jemmott/rotary-plasma/headstock/out/adapter_plate.dxf

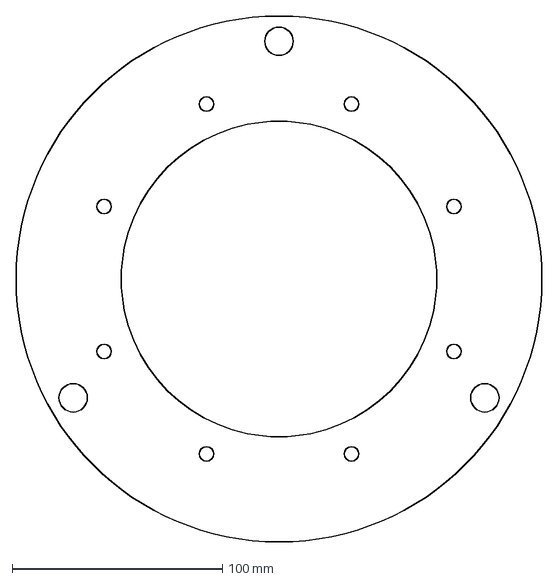
[picture p1: CAD file, 2026-11-13]
headstock/out/adapter_plate.dxf
250.0 x 250.0 mm
