jemmott/rotary-plasma/headstock/out/spacer_ring.dxf

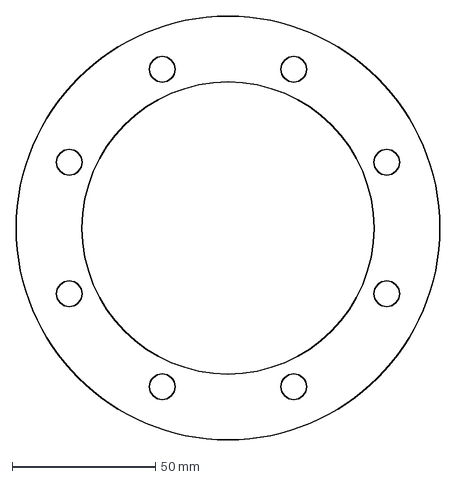
[picture p2: CAD file, 2026-11-13]
headstock/out/spacer_ring.dxf
148.0 x 148.0 mm
