jemmott/rotary-plasma/headstock/out/frame_plate.dxf

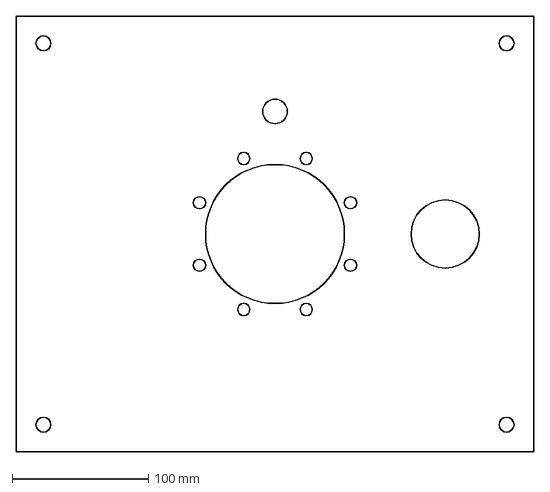
[picture p3: CAD file, 2026-11-13]
headstock/out/frame_plate.dxf
380.0 x 320.0 mm
