jemmott/rotary-plasma/(commit log)

2026-11-10 Initial repo: design docs, headstock comparison, draft BOM, cope CAM spike
2026-11-13 Record chuck measurements; pick 011.10.150 slewing ring; draw headstock plates
    [adapter_plate.dxf, frame_plate.dxf, spacer_ring.dxf]
2026-11-13 Record orders and PG4 motor; add CERN-OHL-P v2 text; update status for handoff
